ephonk/mixpre-control-surface-bridge/enclosure/box top.stl

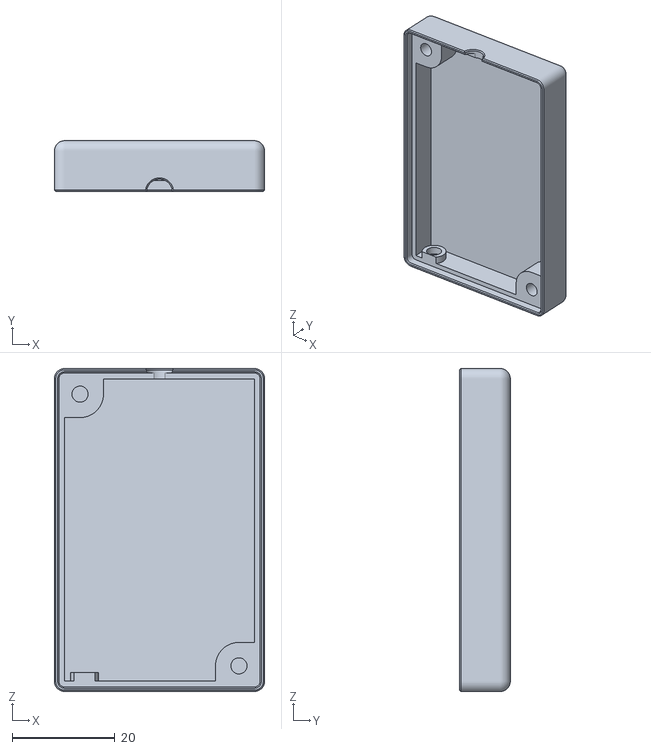
[picture p6: CAD file, 2026-10-10]
enclosure/box top.stl
41.0 x 9.88 x 63.0
