ephonk/mixpre-control-surface-bridge/enclosure/cable clamp.stl

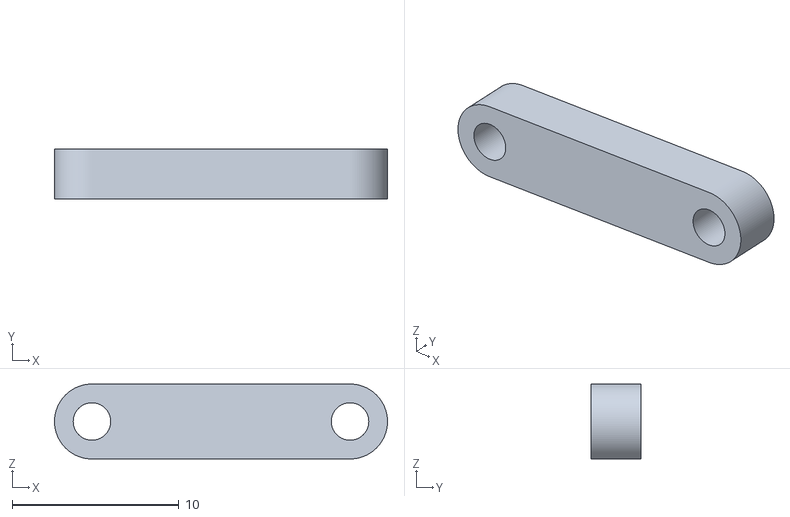
[picture p7: CAD file, 2026-10-10]
enclosure/cable clamp.stl
20.0 x 3.00 x 4.50
