ephonk/mixpre-control-surface-bridge/enclosure/box bottom.stl

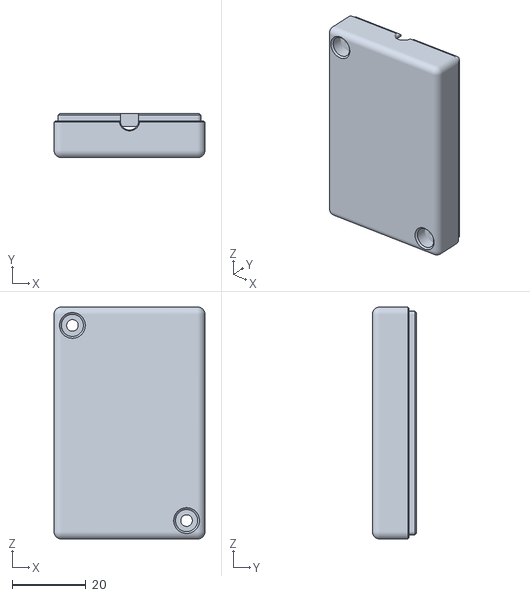
[picture p8: CAD file, 2026-10-10]
enclosure/box bottom.stl
41.0 x 12.0 x 63.0
