ephonk/mixpre-control-surface-bridge/pico-bridge/firmware/korg_defaults.h

#ifndef _KORG_DEFAULTS_H_
#define _KORG_DEFAULTS_H_
#include <stdint.h>
// Real nanoKONTROL Studio data captured from the device (Global + Scene dump)
static const uint8_t korg_global_data[128] = {
  0x00, 0x00, 0x00, 0x00, 0xFF, 0xFF, 0xFF, 0xFF, 0x6E, 0x61, 0x6E, 0x6F, 0x4B, 0x4F, 0x4E, 0x54,
  0x52, 0x4F, 0x4C, 0x20, 0x53, 0x74, 0x75, 0x64, 0x69, 0x6F, 0x00, 0x00, 0x00, 0x00, 0x00, 0x00,
  0x00, 0x00, 0xFF, 0xFF, 0xFF, 0xFF, 0xFF, 0xFF, 0xFF, 0xFF, 0xFF, 0xFF, 0xFF, 0xFF, 0xFF, 0xFF,
  0xFF, 0xFF, 0xFF, 0xFF, 0xFF, 0xFF, 0xFF, 0xFF, 0xFF, 0xFF, 0xFF, 0xFF, 0xFF, 0xFF, 0xFF, 0xFF,
  0x00, 0x00, 0x02, 0x00, 0xFF, 0xFF, 0xFF, 0xFF, 0x03, 0x01, 0x01, 0x01, 0xFF, 0xFF, 0xFF, 0xFF,
  0x00, 0x00, 0xFF, 0xFF, 0xFF, 0xFF, 0xFF, 0xFF, 0xFF, 0xFF, 0xFF, 0xFF, 0xFF, 0xFF, 0xFF, 0xFF,
  0xFF, 0xFF, 0xFF, 0xFF, 0xFF, 0xFF, 0xFF, 0xFF, 0xFF, 0xFF, 0xFF, 0xFF, 0xFF, 0xFF, 0xFF, 0xFF,
  0xFF, 0xFF, 0xFF, 0xFF, 0xFF, 0xFF, 0xFF, 0xFF, 0xFF, 0xFF, 0xFF, 0xFF, 0xFF, 0xFF, 0xFF, 0xFF,
};

static const uint8_t korg_scene_data[560] = {
  0x4D, 0x69, 0x78, 0x50, 0x72, 0x65, 0x20, 0x20, 0x20, 0x20, 0x20, 0x20, 0x01, 0xFF, 0xFF, 0xFF,
  0x00, 0x00, 0x0D, 0x00, 0x7F, 0xFF, 0xFF, 0xFF, 0x00, 0x00, 0x0E, 0x00, 0x7F, 0xFF, 0xFF, 0xFF,
  0x00, 0x00, 0x0F, 0x00, 0x7F, 0xFF, 0xFF, 0xFF, 0x00, 0x00, 0x10, 0x00, 0x7F, 0xFF, 0xFF, 0xFF,
  0x00, 0x00, 0x11, 0x00, 0x7F, 0xFF, 0xFF, 0xFF, 0x00, 0x00, 0x12, 0x00, 0x7F, 0xFF, 0xFF, 0xFF,
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
  0xFF, 0xFF, 0xFF, 0xFF, 0xFF, 0xFF, 0xFF, 0xFF, 0xFF, 0xFF, 0xFF, 0xFF, 0xFF, 0xFF, 0xFF, 0xFF,
  0xFF, 0xFF, 0xFF, 0xFF, 0xFF, 0xFF, 0xFF, 0xFF, 0xFF, 0xFF, 0xFF, 0xFF, 0xFF, 0xFF, 0xFF, 0xFF,
};

#endif
