ephonk/mixpre-control-surface-bridge/pico-bridge/firmware/version.h

#ifndef _VERSION_H_
#define _VERSION_H_

// Bump this on every release. It ends up in the name of the .uf2 file, in the
// changelog, and in the reply to the debug command F0 7D 61 F7, so it is always
// possible to tell which build sits on a Pico without guessing.
#define FW_VERSION "1.2.2"

#endif
