ephonk/mixpre-control-surface-bridge/(commit log)

2026-10-10 MixPre control surface bridge: use a Mackie control surface with a Sound Devices MixPre
    [box bottom.stl, box top.stl, cable clamp.stl]
2026-10-10 Images: descriptive names, drop two duplicates and the earlier case design, show the cable clamp and side views in Assembly
2026-10-10 Use the on set photo as the hero image, move the case render to Hardware
